cakeypop/JFET-Preamp-ADC-mother-daughter-board/JFET_Preamp_Daughter/production/bom.csv

Designator | Footprint | Quantity | Value | LCSC Part #
C101, C104, C105, C106, C107, C108, C109, C110, C111, C112 | 0402 | 10 | 10u | C15525
C102, C103 | 0402 | 2 | 0.1u | C1525
C113 | 0402 | 1 | 2.2u | C12530
D101 | 0603 | 1 | LED | C2286
R101 | 0603 | 1 | 1k | C21190
R102, R103 | 0603 | 2 | 0 | C21189
U101 | TSSOP-30_4.4x7.8mm_P0.5mm | 1 | PCM1865DBTR | C181312
