cakeypop/JFET-Preamp-ADC-mother-daughter-board/JFET_Preamp_Mother/mother.csv

Reference | Qty | Value | DNP | Exclude from BOM | Exclude from Board | Footprint | Datasheet | LCSC Part #
C102 | 1 | 1u |  |  |  | Capacitor_SMD:C_0603_1608Metric |  | C15849
C103 | 1 | 100n |  |  |  | Capacitor_SMD:C_0603_1608Metric |  | C14663
C201,C202,C203,C301,C302,C303,C401,C402,C403,C501,C502,C503 | 12 | 220p |  |  |  | Capacitor_SMD:C_0603_1608Metric |  | C1603
D101 | 1 | BZV55C27 |  |  |  | Diode_SMD:D_MiniMELF | https://assets.nexperia.com/documents/data-sheet/BZV55_SER.pdf | C545374
D102 | 1 | SMAJ26CA |  |  |  | Diode_SMD:D_SMA | https://www.littelfuse.com/media?itemid=75e32973-b177-4ee3-a0ff-cedaf1abdb93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 | C148226
D103 | 1 | LED |  |  |  | LED_SMD:LED_0603_1608Metric |  | C2286
D201,D202,D301,D302,D401,D402,D501,D502 | 8 | D_TVS |  |  |  | Diode_SMD:D_SMA |  | C148226
Q101 | 1 | AO3401A |  |  |  | Package_TO_SOT_SMD:SOT-23 | http://www.aosmd.com/pdfs/datasheet/AO3401A.pdf | C15127
Q201,Q202,Q203,Q301,Q302,Q303,Q401,Q402,Q403,Q501,Q502,Q503 | 12 | 2SK209 |  |  |  | Package_TO_SOT_SMD:SOT-23 |  | C2880444
R101 | 1 | 100k |  |  |  | Resistor_SMD:R_0603_1608Metric |  | C25803
R102,R211,R212,R213,R311,R312,R313,R411,R412,R413,R511,R512,R513 | 13 | 0 |  |  |  | Resistor_SMD:R_0603_1608Metric |  | C21189
R103 | 1 | 4.7k |  |  |  | Resistor_SMD:R_0603_1608Metric |  | C25999
R201,R202,R205,R209,R301,R302,R305,R309,R401,R402,R405,R409,R501,R502,R505,R509 | 16 | 6.81k |  |  |  | Resistor_SMD:R_0603_1608Metric |  | C137687
R203,R204,R208,R210,R303,R304,R308,R310,R403,R404,R408,R410,R503,R504,R508,R510 | 16 | 3M |  |  |  | Resistor_SMD:R_0603_1608Metric |  | C23156
R206,R306,R406,R506 | 4 | 470 |  |  |  | Resistor_SMD:R_0603_1608Metric |  | C25117
R207,R307,R407,R507 | 4 | 150 |  |  |  | Resistor_SMD:R_0603_1608Metric |  | C22808
