cakeypop/JFET-Preamp-ADC-mother-daughter-board/JFET_Preamp_Daughter/daughter.kicad_pcb

## KiCad design JFET_Preamp_Daughter/daughter.kicad_pcb (2026-06-30)

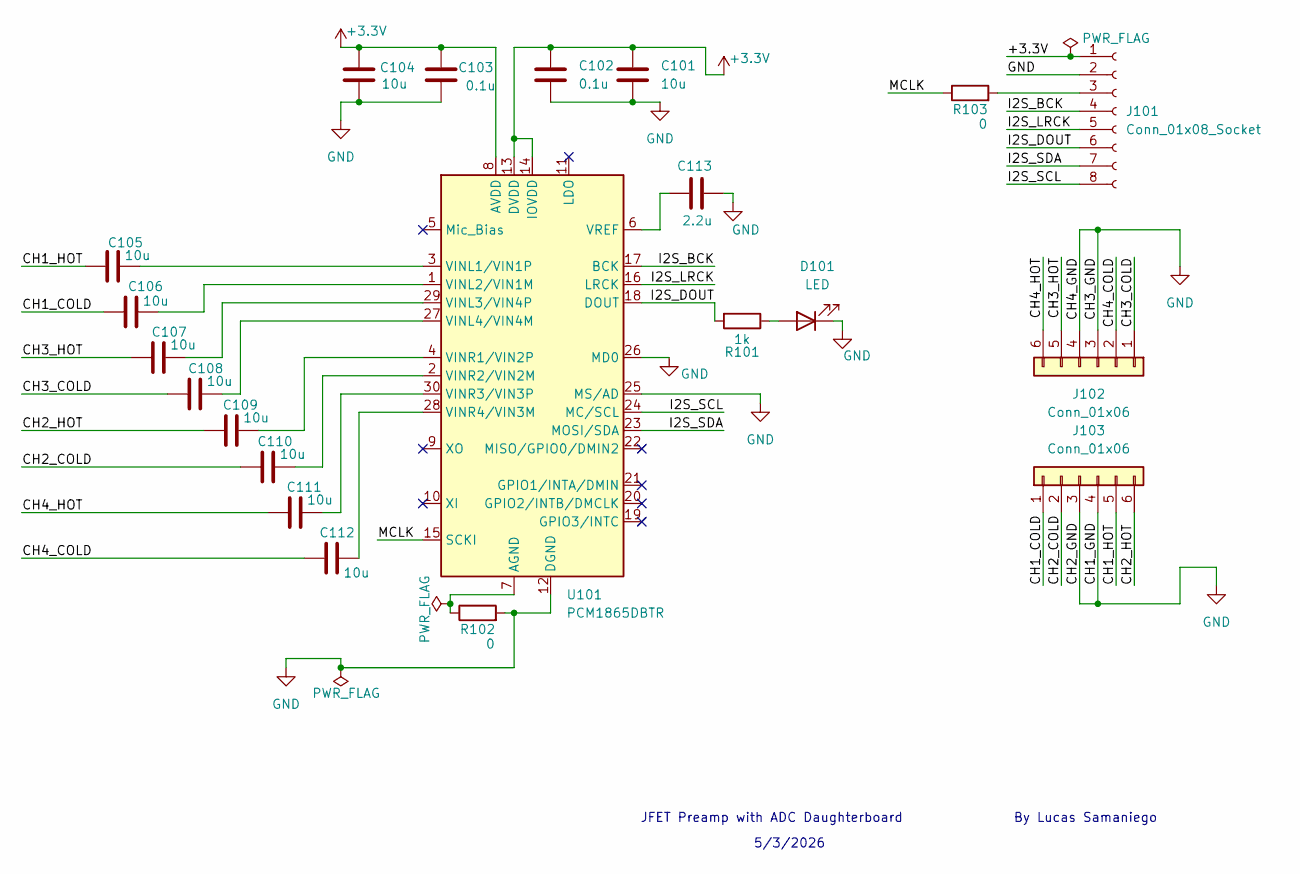
[picture p1: schematic daughter.kicad_sch]

Parts:
C101, C104, C105, C106, C107, C108, C109, C110, C111, C112: 10u; C_0402_1005Metric; LCSC Part # C15525
C102, C103: 0.1u; C_0402_1005Metric; LCSC Part # C1525
C113: 2.2u; C_0402_1005Metric; LCSC Part # C12530
D101: LED; LED_0603_1608Metric; LCSC Part # C2286
J101: Conn_01x08_Socket; JST_GH_BM08B-GHS-TBT_1x08-1MP_P1.25mm_Vertical
J102, J103: Conn_01x06; PinHeader_1x06_P2.54mm_Vertical
R101: 1k; R_0603_1608Metric; LCSC Part # C21190
R102, R103: 0; R_0603_1608Metric; LCSC Part # C21189
U101: PCM1865DBTR; TSSOP-30_4.4x7.8mm_P0.5mm; LCSC Part # C181312

Connections:
+3.3V: C101.1, C102.1, C103.1, C104.1, J101.1, U101.8 (AVDD), U101.13 (DVDD), U101.14 (IOVDD)
/CH1_COLD: C106.1, J103.1
/CH1_HOT: C105.1, J103.5
/CH2_COLD: C110.1, J103.2
/CH2_HOT: C109.1, J103.6
/CH3_COLD: C108.1, J102.1
/CH3_HOT: C107.1, J102.5
/CH4_COLD: C112.1, J102.2
/CH4_HOT: C111.1, J102.6
/I2S_BCK: J101.4, U101.17 (BCK)
/I2S_DOUT: J101.6, R101.2, U101.18 (DOUT)
/I2S_LRCK: J101.5, U101.16 (LRCK)
/I2S_SCL: J101.8, U101.24 (MC/SCL)
/I2S_SDA: J101.7, U101.23 (MOSI/SDA)
/MCLK: R103.1, U101.15 (SCKI)
GND: C101.2, C102.2, C103.2, C104.2, C113.2, D101.1 (K), J101.2, J102.3, J102.4, J103.3, J103.4, R102.2, U101.12 (DGND), U101.25 (MS/AD), U101.26 (MD0)
unnamed: D101.2 (A), R101.1
unnamed: J101.3, R103.2
unnamed: R102.1, U101.7 (AGND)
unnamed: C105.2, U101.3 (VINL1/VIN1P)
unnamed: C106.2, U101.1 (VINL2/VIN1M)
unnamed: C107.2, U101.29 (VINL3/VIN4P)
unnamed: C108.2, U101.27 (VINL4/VIN4M)
unnamed: C109.2, U101.4 (VINR1/VIN2P)
unnamed: C110.2, U101.2 (VINR2/VIN2M)
unnamed: C111.2, U101.30 (VINR3/VIN3P)
unnamed: C112.2, U101.28 (VINR4/VIN3M)
unnamed: C113.1, U101.6 (VREF)

Notes on the sheet:
JFET Preamp with ADC Daughterboard By Lucas Samaniego
5/3/2026

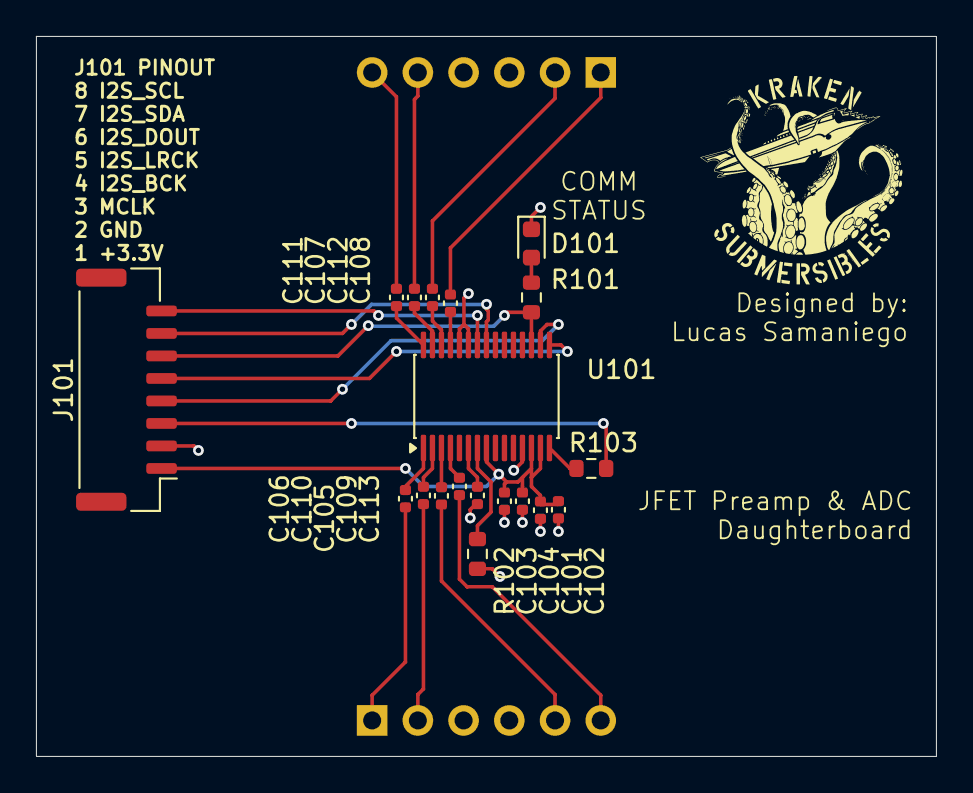
[picture p2: board daughter.kicad_pcb from above]

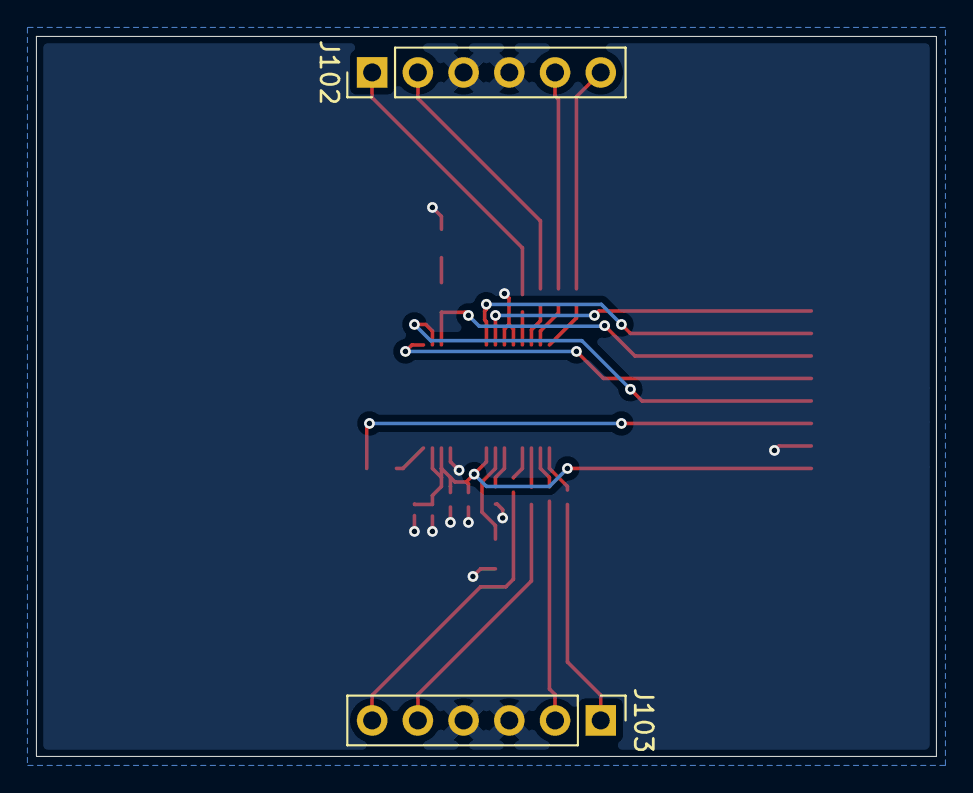
[picture p3: board daughter.kicad_pcb from below]

Board: 2 copper layers, 50.0 x 40.0 mm, 21 parts (2 on the bottom side), 28 nets.
