cakeypop/JFET-Preamp-ADC-mother-daughter-board/JFET_Preamp_Mother/mother.kicad_pcb

## KiCad design JFET_Preamp_Mother/mother.kicad_pcb (2026-06-30)

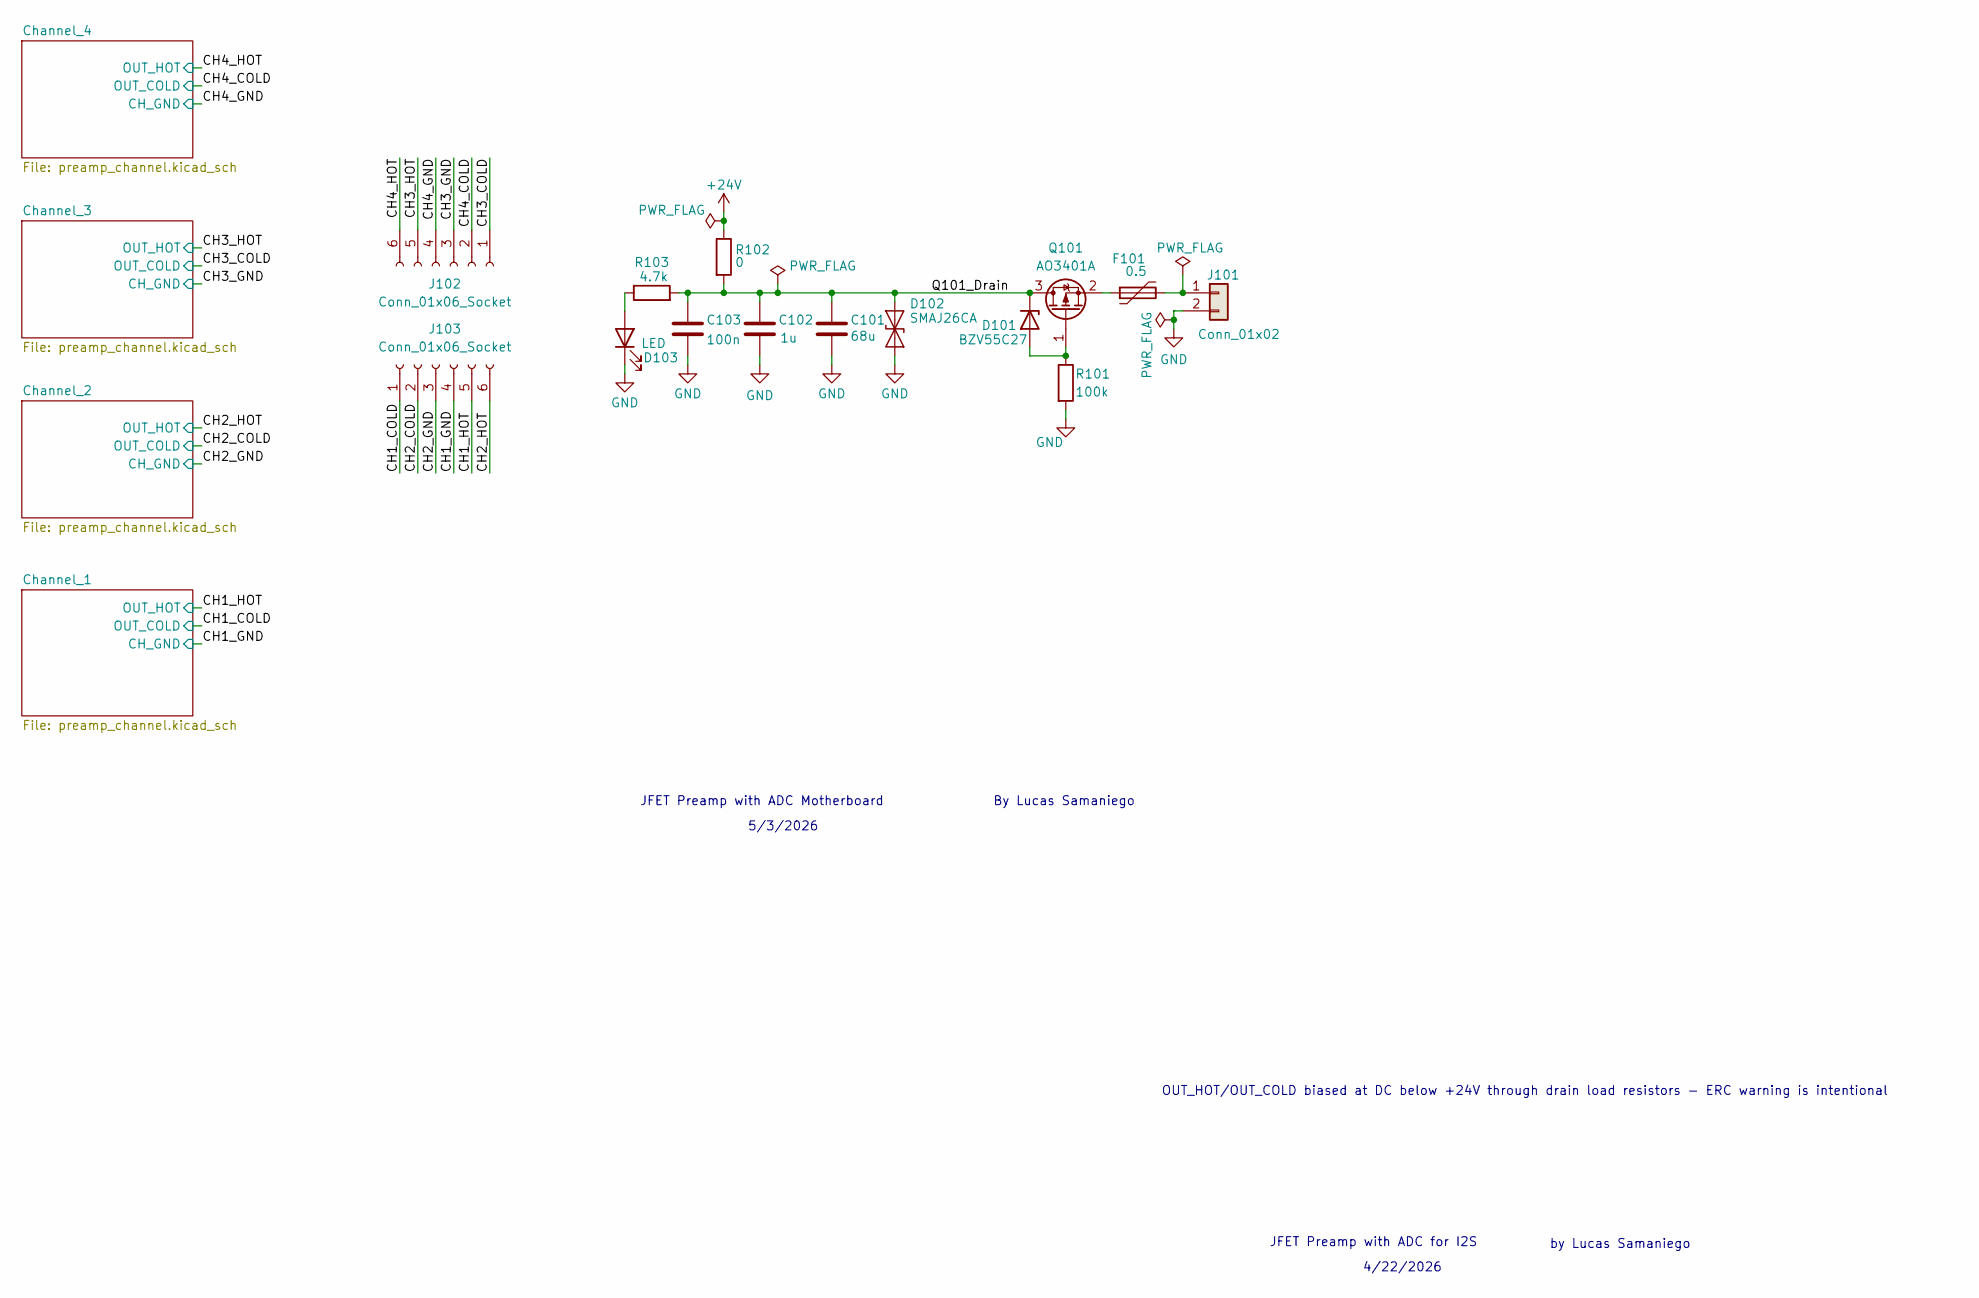
[picture p4: schematic mother.kicad_sch]

Parts:
C101: 68u; CP_Elec_6.3x5.4
C102: 1u; C_0603_1608Metric; LCSC Part # C15849
C103: 100n; C_0603_1608Metric; LCSC Part # C14663
D101: BZV55C27; D_MiniMELF; LCSC Part # C545374
D102: SMAJ26CA; D_SMA; LCSC Part # C148226
D103: LED; LED_0603_1608Metric; LCSC Part # C2286
F101: 0.5; FUSRB510W51L790T310H1370
J101: Conn_01x02; PinHeader_1x02_P2.54mm_Vertical
J102, J103: Conn_01x06_Socket; PinSocket_1x06_P2.54mm_Vertical
Q101: AO3401A; SOT-23; LCSC Part # C15127
R101: 100k; R_0603_1608Metric; LCSC Part # C25803
R102: 0; R_0603_1608Metric; LCSC Part # C21189
R103: 4.7k; R_0603_1608Metric; LCSC Part # C25999

Connections:
+24V: R102.1; also elsewhere on the board
/CH1_COLD: J103.1; also elsewhere on the board
/CH1_GND: J103.4; also elsewhere on the board
/CH1_HOT: J103.5; also elsewhere on the board
/CH2_COLD: J103.2; also elsewhere on the board
/CH2_GND: J103.3; also elsewhere on the board
/CH2_HOT: J103.6; also elsewhere on the board
/CH3_COLD: J102.1; also elsewhere on the board
/CH3_GND: J102.3; also elsewhere on the board
/CH3_HOT: J102.5; also elsewhere on the board
/CH4_COLD: J102.2; also elsewhere on the board
/CH4_GND: J102.4; also elsewhere on the board
/CH4_HOT: J102.6; also elsewhere on the board
/Q101_Drain: C101.1, C102.1, C103.1, D101.1 (K), D102.2 (A2), Q101.3 (D), R102.2, R103.2
GND: C101.2, C102.2, C103.2, D102.1 (A1), D103.1 (K), J101.2, R101.2
unnamed: D101.2 (A), Q101.1 (G), R101.1
unnamed: D103.2 (A), R103.1
unnamed: F101.2, J101.1
unnamed: F101.1, Q101.2 (S)

Notes on the sheet:
OUT_HOT/OUT_COLD biased at DC below +24V through drain load resistors - ERC warning is intentional
JFET Preamp with ADC for I2S
5/3/2026
by Lucas Samaniego
JFET Preamp with ADC Motherboard By Lucas Samaniego
4/22/2026

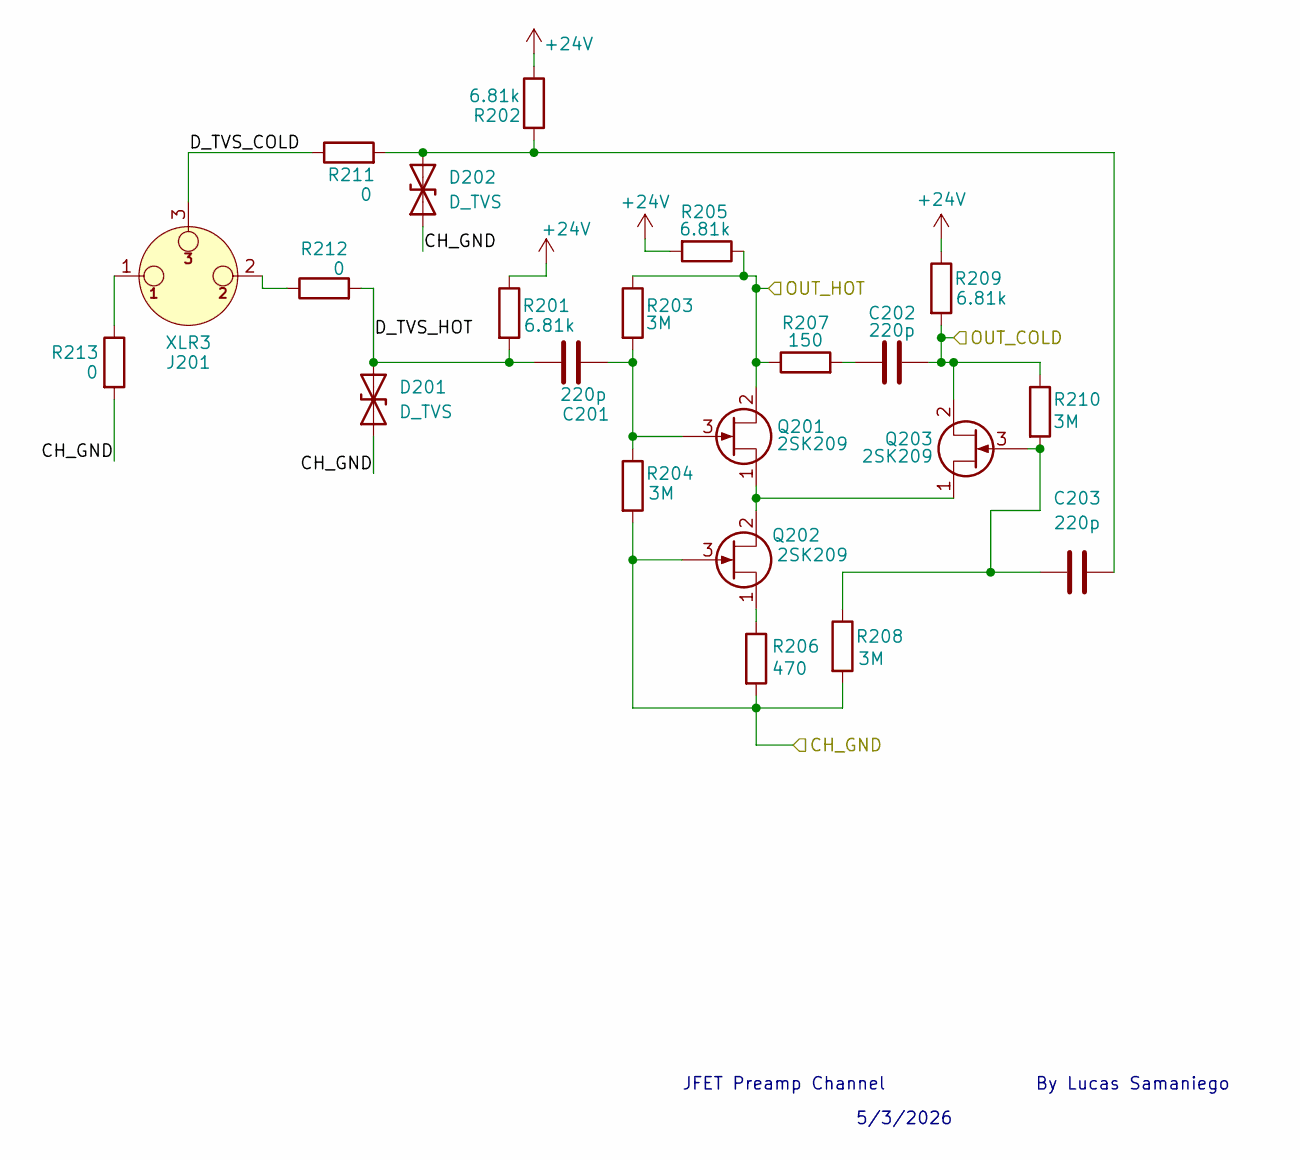
[picture p5: schematic preamp_channel.kicad_sch]

Parts:
C201, C202, C203: 220p; C_0603_1608Metric; LCSC Part # C1603
D201, D202: D_TVS; D_SMA; LCSC Part # C148226
J201: XLR3; Jack_XLR_Neutrik_NC3FAH1_Horizontal
Q201, Q202, Q203: 2SK209; SOT-23; LCSC Part # C2880444
R201, R202, R205, R209: 6.81k; R_0603_1608Metric; LCSC Part # C137687
R203, R204, R208, R210: 3M; R_0603_1608Metric; LCSC Part # C23156
R206: 470; R_0603_1608Metric; LCSC Part # C25117
R207: 150; R_0603_1608Metric; LCSC Part # C22808
R211, R212, R213: 0; R_0603_1608Metric; LCSC Part # C21189

Connections:
+24V: R201.1, R202.1, R205.2, R209.1; also elsewhere on the board
/CH1_COLD: C202.2, Q203.2 (D), R209.2, R210.1; also elsewhere on the board
/CH1_GND: D201.1 (A1), D202.1 (A1), Q202.3 (G), R204.2, R206.2, R208.2, R213.2; also elsewhere on the board
/CH1_HOT: Q201.2 (D), R203.1, R205.1, R207.1; also elsewhere on the board
/Channel_1/D_TVS_COLD: J201.3, R211.1
/Channel_1/D_TVS_HOT: C201.1, D201.2 (A2), R201.2, R212.2
unnamed: C202.1, R207.2
unnamed: C203.2, D202.2 (A2), R202.2, R211.2
unnamed: J201.1, R213.1
unnamed: J201.2, R212.1
unnamed: C201.2, Q201.3 (G), R203.2, R204.1
unnamed: Q201.1 (S), Q202.2 (D), Q203.1 (S)
unnamed: Q202.1 (S), R206.1
unnamed: C203.1, Q203.3 (G), R208.1, R210.2

Parts of its further copies:
C301, C302, C303, C401, C402, C403, C501, C502, C503: 220p; C_0603_1608Metric; LCSC Part # C1603
D301, D302, D401, D402, D501, D502: D_TVS; D_SMA; LCSC Part # C148226
J301, J401, J501: XLR3; Jack_XLR_Neutrik_NC3FAH1_Horizontal
Q301, Q302, Q303, Q401, Q402, Q403, Q501, Q502, Q503: 2SK209; SOT-23; LCSC Part # C2880444
R301, R302, R305, R309, R401, R402, R405, R409, R501, R502, R505, R509: 6.81k; R_0603_1608Metric; LCSC Part # C137687
R303, R304, R308, R310, R403, R404, R408, R410, R503, R504, R508, R510: 3M; R_0603_1608Metric; LCSC Part # C23156
R306, R406, R506: 470; R_0603_1608Metric; LCSC Part # C25117
R307, R407, R507: 150; R_0603_1608Metric; LCSC Part # C22808
R311, R312, R313, R411, R412, R413, R511, R512, R513: 0; R_0603_1608Metric; LCSC Part # C21189

Connections of its further copies:
+24V: R301.1, R302.1, R305.2, R309.1, R401.1, R402.1, R405.2, R409.1, R501.1, R502.1, R505.2, R509.1; also elsewhere on the board
/CH2_COLD: C302.2, Q303.2 (D), R309.2, R310.1; also elsewhere on the board
/CH2_GND: D301.1 (A1), D302.1 (A1), Q302.3 (G), R304.2, R306.2, R308.2, R313.2; also elsewhere on the board
/CH2_HOT: Q301.2 (D), R303.1, R305.1, R307.1; also elsewhere on the board
/CH3_COLD: C402.2, Q403.2 (D), R409.2, R410.1; also elsewhere on the board
/CH3_GND: D401.1 (A1), D402.1 (A1), Q402.3 (G), R404.2, R406.2, R408.2, R413.2; also elsewhere on the board
/CH3_HOT: Q401.2 (D), R403.1, R405.1, R407.1; also elsewhere on the board
/CH4_COLD: C502.2, Q503.2 (D), R509.2, R510.1; also elsewhere on the board
/CH4_GND: D501.1 (A1), D502.1 (A1), Q502.3 (G), R504.2, R506.2, R508.2, R513.2; also elsewhere on the board
/CH4_HOT: Q501.2 (D), R503.1, R505.1, R507.1; also elsewhere on the board
/Channel_2/D_TVS_COLD: J301.3, R311.1
/Channel_2/D_TVS_HOT: C301.1, D301.2 (A2), R301.2, R312.2
/Channel_3/D_TVS_COLD: J401.3, R411.1
/Channel_3/D_TVS_HOT: C401.1, D401.2 (A2), R401.2, R412.2
/Channel_4/D_TVS_COLD: J501.3, R511.1
/Channel_4/D_TVS_HOT: C501.1, D501.2 (A2), R501.2, R512.2
unnamed: C302.1, R307.2
unnamed: C402.1, R407.2
unnamed: C502.1, R507.2
unnamed: C303.2, D302.2 (A2), R302.2, R311.2
unnamed: C403.2, D402.2 (A2), R402.2, R411.2
unnamed: C503.2, D502.2 (A2), R502.2, R511.2
unnamed: J301.1, R313.1
unnamed: J301.2, R312.1
unnamed: J401.1, R413.1
unnamed: J401.2, R412.1
unnamed: J501.1, R513.1
unnamed: J501.2, R512.1
unnamed: C301.2, Q301.3 (G), R303.2, R304.1
unnamed: Q301.1 (S), Q302.2 (D), Q303.1 (S)
unnamed: Q302.1 (S), R306.1
unnamed: C303.1, Q303.3 (G), R308.1, R310.2
unnamed: C401.2, Q401.3 (G), R403.2, R404.1
unnamed: Q401.1 (S), Q402.2 (D), Q403.1 (S)
unnamed: Q402.1 (S), R406.1
unnamed: C403.1, Q403.3 (G), R408.1, R410.2
unnamed: C501.2, Q501.3 (G), R503.2, R504.1
unnamed: Q501.1 (S), Q502.2 (D), Q503.1 (S)
unnamed: Q502.1 (S), R506.1
unnamed: C503.1, Q503.3 (G), R508.1, R510.2

Notes on the sheet:
5/3/2026
JFET Preamp Channel By Lucas Samaniego

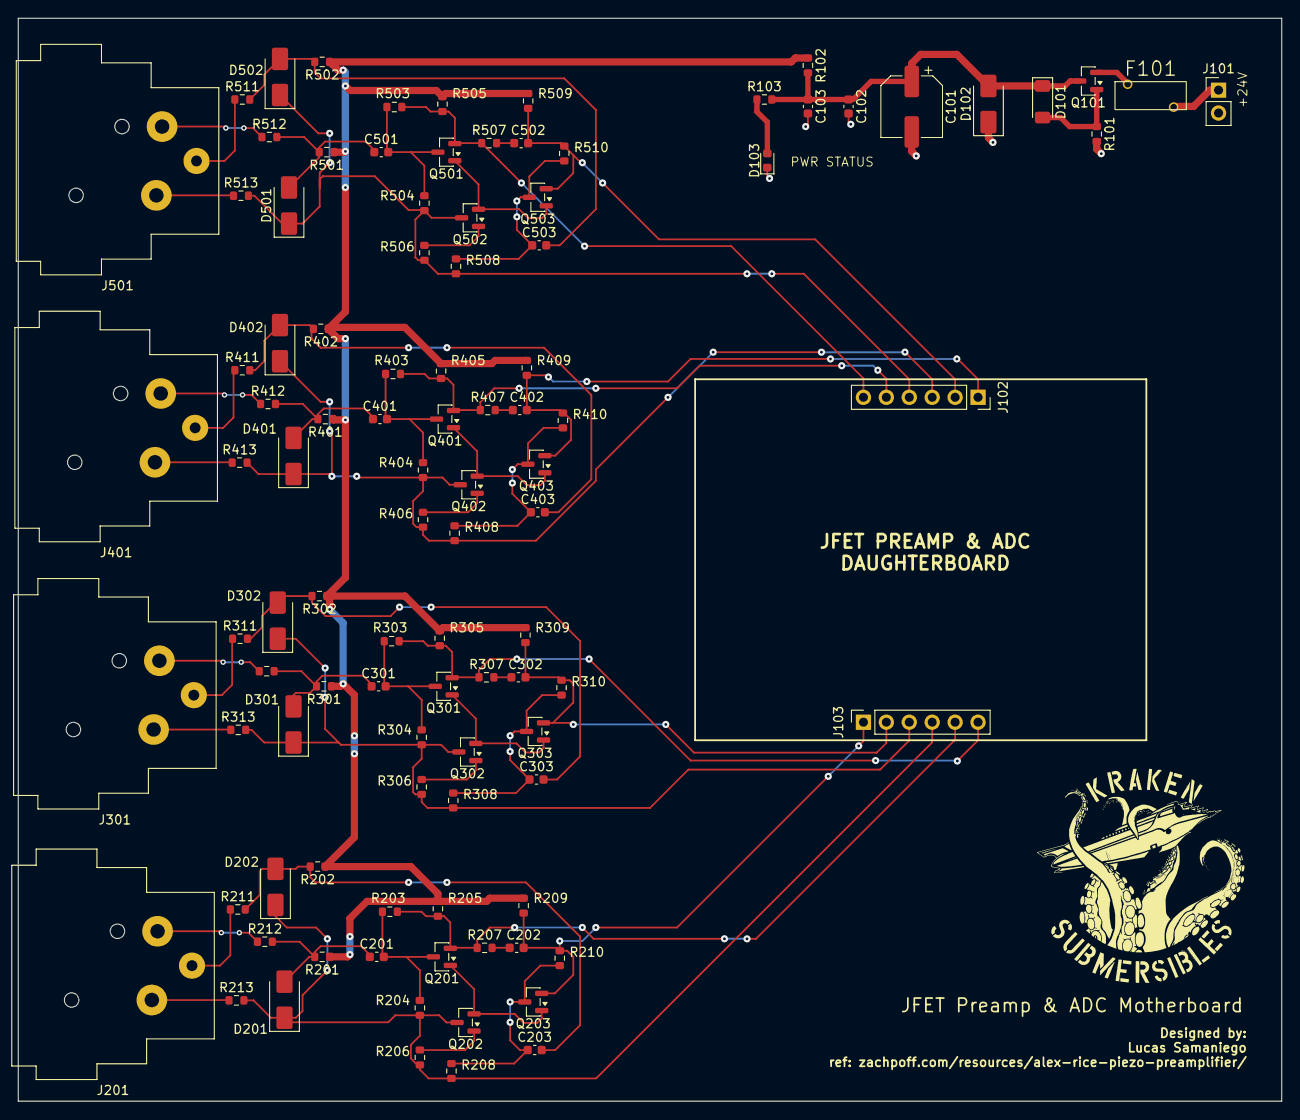
[picture p6: board mother.kicad_pcb from above]

Board: 2 copper layers, 140.0 x 120.0 mm, 102 parts (0 on the bottom side), 59 nets.
