cakeypop/JFET-Preamp-ADC-mother-daughter-board/(commit log)

2026-06-17 Re-Initial commit after errors - mobo/daughter projects
    [.kicad_sch, daughter.kicad_pcb, mother.kicad_pcb, mother.kicad_sch, preamp_channel.kicad_sch]
2026-06-17 motherboard .sch erc clean
    [mother.kicad_sch, preamp_channel.kicad_sch]
2026-06-17 Remove KiCad lock files from tracking, update gitignore
2026-06-17 Remove VS Code history folders and stray file from tracking
    [.kicad_sch]
2026-06-17 move MF-R050 footprint library into repo to use relative path
2026-06-17 daugter removed unused copy of preamp_channel.sch not used in daughterboard
    [daughter.kicad_sch, preamp_channel.kicad_sch]
2026-06-18 finish draft of mother/daughter sch and start routing, reconcile libraries and missing footprints
    [daughter.kicad_pcb, daughter.kicad_sch, mother.kicad_sch, preamp_channel.kicad_sch]
2026-06-18 adding a few minor edits
    [daughter.kicad_sch]
2026-06-19 finish routing daughterboard and fix 0 ohm resistor on AGND/DGND for schematic
    [daughter.kicad_pcb, daughter.kicad_sch]
2026-06-19 add silkscreen to pcb daughterboard, possibly final pending review
    [daughter.kicad_pcb]
2026-06-19 fix ERC on schematic, then proceed to begin routing on pcb
    [mother.kicad_pcb]
2026-06-19 forgot to save ERC change adding pwr flag to mother sch
    [mother.kicad_sch]
2026-06-24 push just to make sure everything is up to date
    [mother.kicad_sch]
2026-06-30 WIP motherboard pcb save point, layout and partial routing complete
    [mother.kicad_pcb, mother.kicad_sch]
2026-06-30 fix backwards J102 on daughterboard to match schematic and mother/daughter pairing
    [daughter.kicad_pcb]
2026-06-30 finished pcb, updated schematic formatting, ready for fab
    [mother.kicad_pcb, mother.kicad_sch, preamp_channel.kicad_sch]
2026-06-30 small updates to schematic before adjusting/printing pdf
    [daughter.kicad_sch]
2026-06-30 further adjustments to sch/pcb
    [daughter.kicad_pcb]
2026-06-30 fixed wrong-facing 6pin connector and redo GND pour
    [daughter.kicad_pcb]
2026-06-30 generate gerber and drill files
    [daughter-B_Cu.gbl, daughter-B_Mask.gbs, daughter-B_Paste.gbp, daughter-B_Silkscreen.gbo, daughter-Edge_Cuts.gm1, daughter-F_Cu.gtl, daughter-F_Mask.gts, daughter-F_Paste.gtp]
2026-06-30 fix error in gerber, extra layers
    [daughter-B_Cu.gbl, daughter-B_Mask.gbs, daughter-B_Paste.gbp, daughter-B_Silkscreen.gbo, daughter-Edge_Cuts.gm1, daughter-F_Cu.gtl, daughter-F_Mask.gts, daughter-F_Paste.gtp]
2026-06-30 regenerate mother gerber and drill
    [mother-B_Cu.gbr, mother-B_Mask.gbr, mother-B_Paste.gbr, mother-B_Silkscreen.gbr, mother-Edge_Cuts.gbr, mother-F_Cu.gbr, mother-F_Mask.gbr, mother-F_Paste.gbr]
2026-06-30 fixed TVS Diodes across 4 channels and redo placement and traces
    [mother-B_Cu.gbr, mother-B_Mask.gbr, mother-B_Paste.gbr, mother-B_Silkscreen.gbr, mother-Edge_Cuts.gbr, mother-F_Cu.gbr, mother-F_Mask.gbr, mother-F_Paste.gbr]
2026-06-30 finished for first fab Mother order, pending daughter
    [bom.csv, designators.csv, positions.csv]
2026-06-30 update Capacitors to better suit and rebuild, prep for fab, final for 1st fab
    [bom.csv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]
2026-06-30 small changes to pcb
